dubpixel/DPX_flatbox/dpx-v7/Flatbox-rev7-kicad/Flatbox-rev7.png

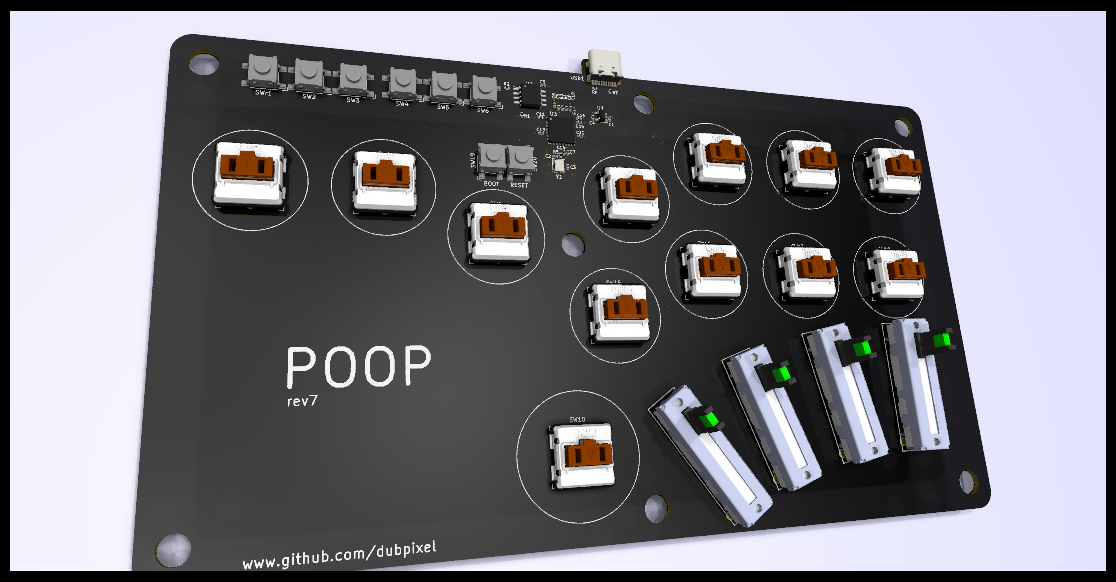
dpx-v7/Flatbox-rev7-kicad/Flatbox-rev7.png
