dubpixel/DPX_flatbox/hardware-rev4_LED-Fightingbox/3d-printed-case/flatbox_rev4_rgb_top.stl

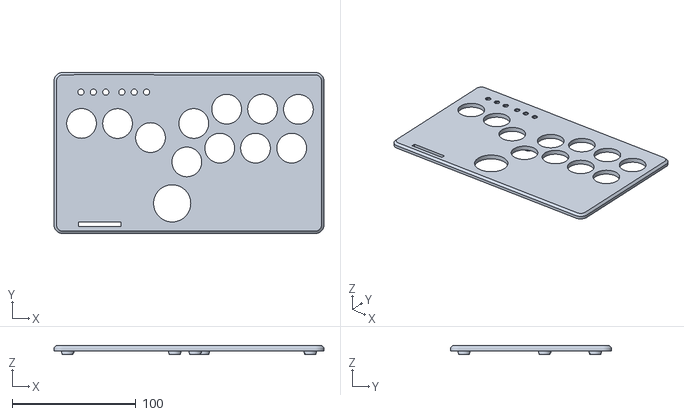
[picture p6: CAD file, 2024-12-09]
hardware-rev4_LED-Fightingbox/3d-printed-case/flatbox_rev4_rgb_top.stl
218.0 x 130.1 x 7.29
