dubpixel/DPX_flatbox/hardware-rev7/3d-printed-case/Flatbox-rev7-Bottom.stl

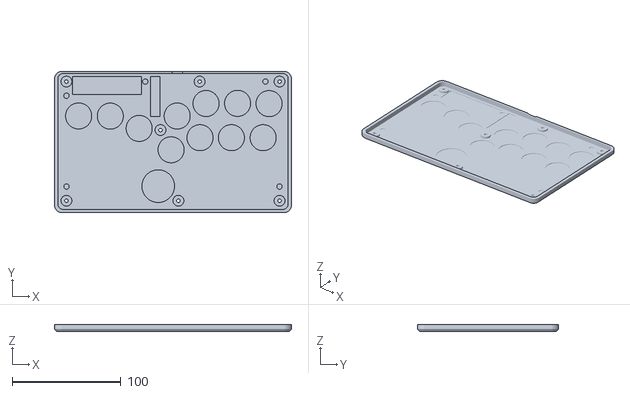
[picture p7: CAD file, 2024-12-09]
hardware-rev7/3d-printed-case/Flatbox-rev7-Bottom.stl
218.0 x 130.0 x 6.20
