dubpixel/DPX_flatbox/hardware-rev4_LED-Fightingbox/3d-printed-case/Flatbox-rev4-Bottom-hotswap.stl

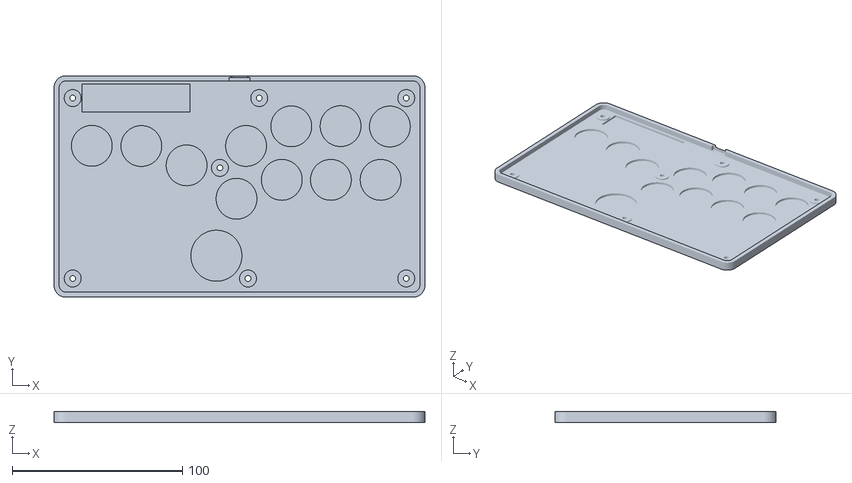
[picture p9: CAD file, 2024-12-09]
hardware-rev4_LED-Fightingbox/3d-printed-case/Flatbox-rev4-Bottom-hotswap.stl
218.0 x 130.1 x 6.20
