dubpixel/DPX_flatbox/hardware-rev7/3d-printed-case/Flatbox-rev7-Top.stl

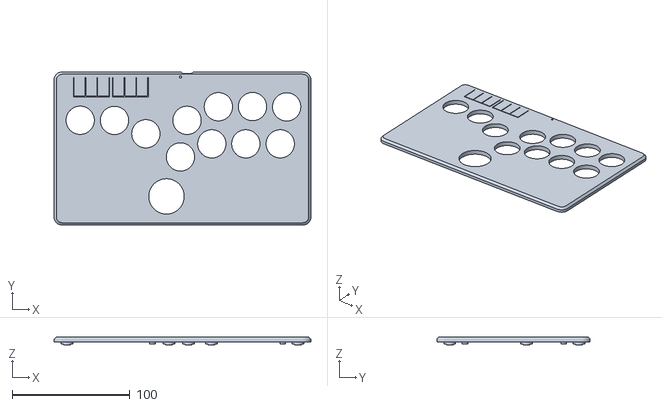
[picture p10: CAD file, 2024-12-09]
hardware-rev7/3d-printed-case/Flatbox-rev7-Top.stl
218.0 x 130.0 x 7.20
