dubpixel/DPX_flatbox/hardware-rev7/extras/Flatbox-rev7-pcb.step

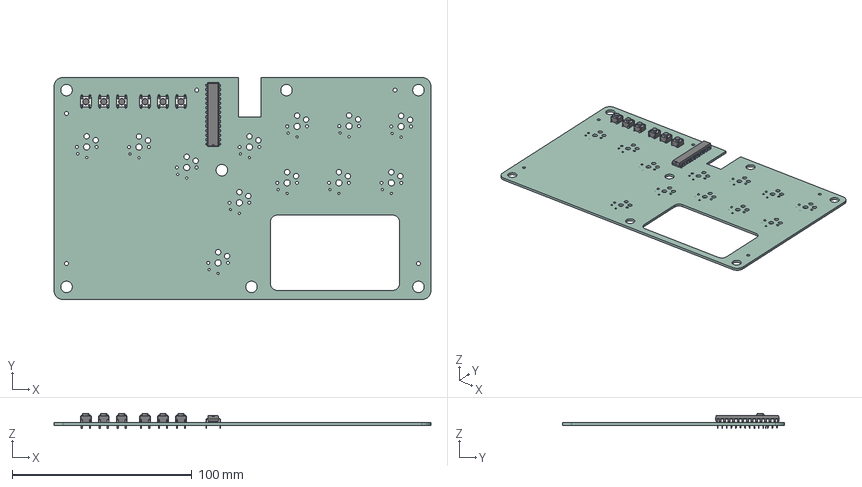
[picture p11: CAD file, 2024-12-09]
hardware-rev7/extras/Flatbox-rev7-pcb.step
210.0 x 123.6 x 8.50 mm
SW_PUSH_6mm_h5mm x 6
DIP-28_W7.62mm
Flatbox-rev7_PCB
