dubpixel/DPX_flatbox/hardware-rev6/3d-printed-case/Flatbox-rev6-Bottom-hotswap.stl

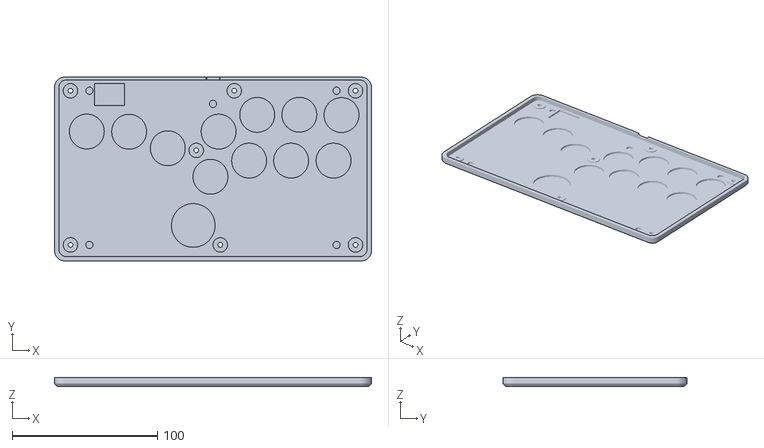
[picture p12: CAD file, 2024-12-09, an earlier design]
hardware-rev6/3d-printed-case/Flatbox-rev6-Bottom-hotswap.stl
218.0 x 126.4 x 6.20
