dubpixel/DPX_flatbox/hardware-rev6/extras/Flatbox-rev6-pcb.step

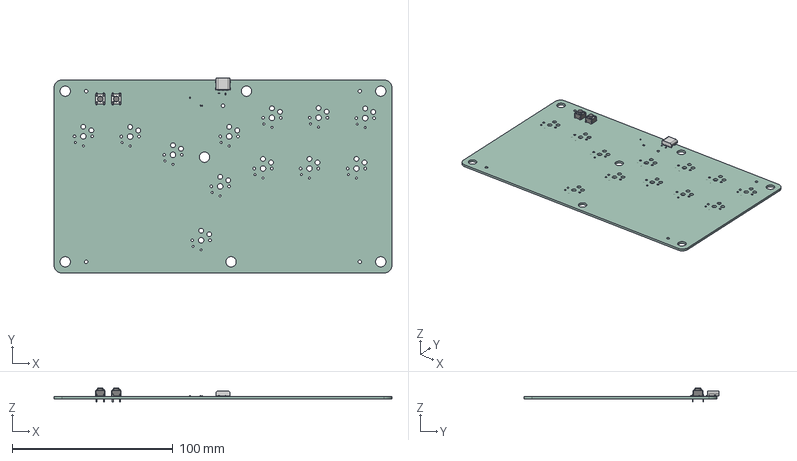
[picture p16: CAD file, 2024-12-09, an earlier design]
hardware-rev6/extras/Flatbox-rev6-pcb.step
210.0 x 121.2 x 8.50 mm
SW_PUSH_6mm_h5mm x 2
R_0402_1005Metric x 3
HRO TYPE-C-31-M-12 v4
C_0402_1005Metric x 2
Flatbox-rev6_PCB
