dubpixel/DPX_flatbox/(list of files, cad)

Other CAD files:
hardware-rev6/extras/Flatbox-rev6-case-hotswap.step
