dubpixel/DPX_flatbox/dpx-v7/Flatbox-rev7-kicad/Flatbox-rev7.kicad_pcb

## KiCad design dpx-v7/Flatbox-rev7-kicad/Flatbox-rev7.kicad_pcb (2024-12-09)

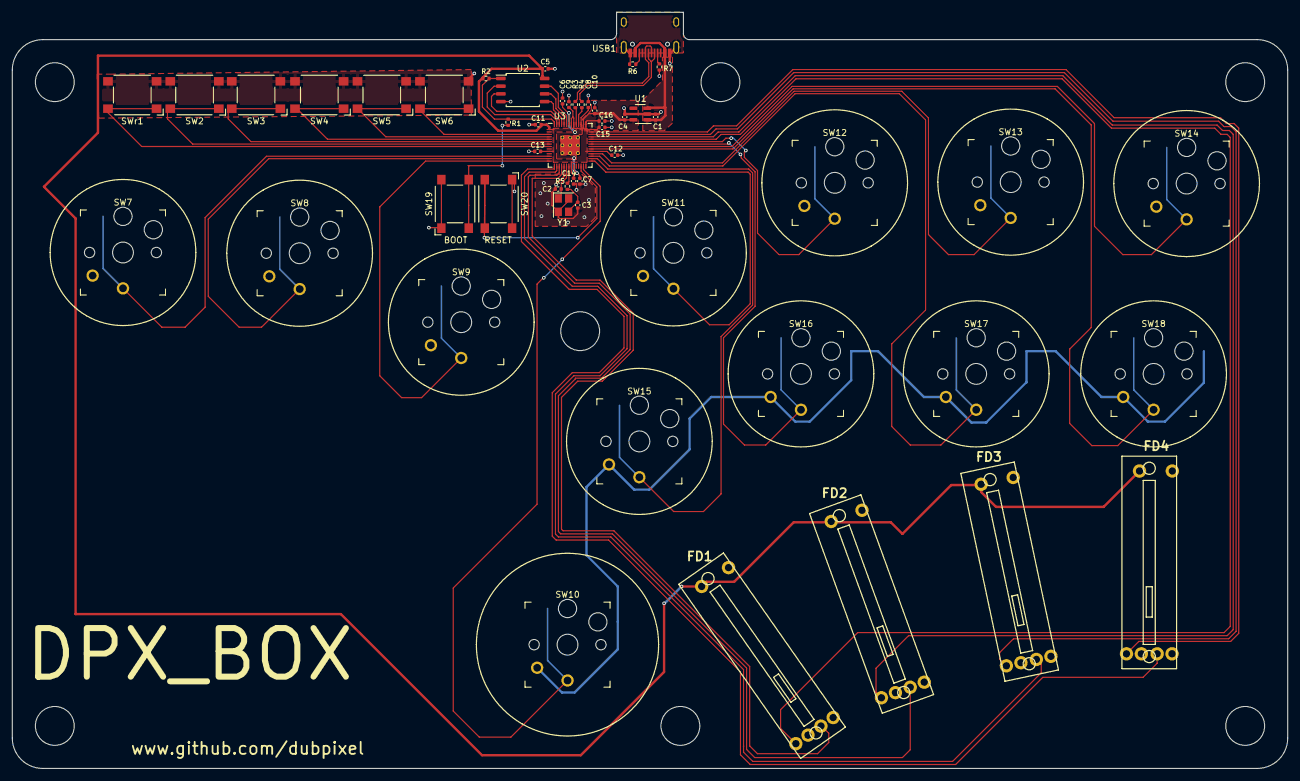
[picture p17: board Flatbox-rev7.kicad_pcb from above]

Board: 2 copper layers, 210.0 x 124.5 mm, 52 parts (0 on the bottom side), 47 nets.

Parts:
C1, C4, C8, C10: 1u; C_0402_1005Metric
C2, C3: 30p; C_0402_1005Metric
C5, C6, C7, C9, C11, C12, C13, C14, C15, C16: 100n; C_0402_1005Metric
F1, F2, F3, F4: BOURNS-PTL2043_20mm-slide-pot
R1, R5: 1k; R_0402_1005Metric
R2: 10k; R_0402_1005Metric
R3, R4: 27; R_0402_1005Metric
R6, R7: 5.1k; R_0402_1005Metric
SW2, SW3, SW4, SW5, SW6, SW19, SW20: SW_Push; SW_SPST_Omron_B3FS-100xP
SW7, SW8, SW9, SW11, SW12, SW13, SW14, SW15, SW16, SW17, SW18: SW_Push; Kailh_socket_PG1350_optional
SW10: SWX10; Kailh_socket_PG1350_optional
SWr1: SW_Push; SW_SPST_Omron_B3FS-100xP
U1: TLV73333PDBV; SOT-23-5
U2: W25Q128JVS; SOIC-8_5.23x5.23mm_P1.27mm
U3: RP2040; RP2040-QFN-56
USB1: HRO-TYPE-C-31-M-12; HRO-TYPE-C-31-M-12-Assembly
Y1: Crystal_GND24; Crystal_SMD_3225-4Pin_3.2x2.5mm

Connections:
+1V1: C6.1, C7.1, C8.1, U3.23 (DVDD), U3.45 (VREG_VOUT), U3.50 (DVDD)
+3V3: C4.1, C5.1, C9.1, C10.1, C11.1, C12.1, C13.1, C14.1, C15.1, C16.1, F1.3, F2.3, F3.3, F4.3, R2.1, U1.5 (OUT), U2.8 (VCC), U3.1 (IOVDD), U3.10 (IOVDD), U3.22 (IOVDD), U3.33 (IOVDD), U3.42 (IOVDD), U3.43 (ADC_AVDD), U3.44 (VREG_IN), U3.48 (USB_VDD), U3.49 (IOVDD)
+5V: C1.1, U1.1 (IN), U1.3 (EN), USB1.2 (VBUS), USB1.11 (VBUS)
ADC0: F1.2, U3.38 (GPIO26_ADC0)
ADC1: F2.2, U3.39 (GPIO27_ADC1)
ADC2: F3.2, U3.40 (GPIO28_ADC2)
ADC3: F4.2, U3.41 (GPIO29_ADC3)
D+: R3.1, USB1.6 (DP1), USB1.8 (DP2)
D-: R4.1, USB1.5 (DN2), USB1.7 (DN1)
GND: C1.2, C2.1, C3.2, C4.2, C5.2, C6.2, C7.2, C8.2, C9.2, C10.2, C11.2, C12.2, C13.2, C14.2, C15.2, C16.2, F1.1, F1.C (CATHODE), F2.C (CATHODE), F3.1, F3.C (CATHODE), F4.1, F4.C (CATHODE), R6.2, R7.2, SW2.2, SW3.2, SW4.2, SW5.2, SW6.2, SW7.2, SW8.2, SW9.2, SW10.2, SW11.2, SW12.2, SW13.2, SW14.2, SW15.2, SW16.2, SW17.2, SW18.2, SW19.1, SW20.1, SWr1.2, U1.2 (GND), U2.4 (GND), U3.19 (TESTEN), U3.57 (GND), USB1.1 (GND), USB1.12 (GND), USB1.13 (SHIELD), Y1.2, Y1.4
LEDF1: F4.L (EN), U3.15 (GPIO12)
LEDF2: F3.L (EN), U3.16 (GPIO13)
LEDF3: F2.L (EN), U3.17 (GPIO14)
LEDF4: F1.L (EN), U3.18 (GPIO15)
unnamed: C3.1, R5.1, Y1.3
unnamed: R1.2, SW19.2
unnamed: SW20.2, U3.26 (RUN)
unnamed: R4.2, U3.46 (USB_DM)
unnamed: R3.2, U3.47 (USB_DP)
unnamed: R7.1, USB1.4 (CC1)
unnamed: R6.1, USB1.10 (CC2)
QSPI_SCLK: U2.6 (CLK), U3.52 (QSPI_SCLK)
QSPI_SD0: U2.5 (DI(IO0)), U3.53 (QSPI_SD0)
QSPI_SD1: U2.2 (DO(IO1)), U3.55 (QSPI_SD1)
QSPI_SD2: U2.3 (IO2), U3.54 (QSPI_SD2)
QSPI_SD3: U2.7 (IO3), U3.51 (QSPI_SD3)
QSPI_SS: R1.1, R2.2, U2.1 (~CS), U3.56 (QSPI_SS)
SWX1: SWr1.1, U3.8 (GPIO6)
SWX2: SW2.1, U3.7 (GPIO5)
SWX3: SW3.1, U3.6 (GPIO4)
SWX4: SW4.1, U3.5 (GPIO3)
SWX5: SW5.1, U3.4 (GPIO2)
SWX6: SW6.1, U3.3 (GPIO1)
SWX7: SW7.1, U3.12 (GPIO9)
SWX8: SW8.1, U3.13 (GPIO10)
SWX9: SW9.1, U3.14 (GPIO11)
SWX10: SW10.1, U3.27 (GPIO16)
SWX11: SW11.1, U3.29 (GPIO18)
SWX12: SW12.1, U3.37 (GPIO25)
SWX13: SW13.1, U3.32 (GPIO21)
SWX14: SW14.1, U3.35 (GPIO23)
SWX15: SW15.1, U3.30 (GPIO19)
SWX16: SW16.1, U3.36 (GPIO24)
SWX17: SW17.1, U3.31 (GPIO20)
SWX18: SW18.1, U3.34 (GPIO22)
XIN: C2.2, U3.20 (XIN), Y1.1
XOUT: R5.2, U3.21 (XOUT)
