dubpixel/DPX_flatbox/(commit log)

2024-12-09 very messy commit - need to reorg
    very very messy messy. - also includes an RGB fork from @mxd1365
    [BOM-Flatbox-rev7.csv, Flatbox-rev4-Bottom-hotswap.stl, Flatbox-rev4-rgb-BOM.csv, Flatbox-rev4-rgb-kicad-SK6812-20.kicad_pcb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]
2024-12-09 manual merge to be in line with main branch
    [Flatbox-rev6-BOM.csv, Flatbox-rev6-Bottom-hotswap.stl, Flatbox-rev6-Bottom.stl, Flatbox-rev6-Top.stl, Flatbox-rev6-case-hotswap.step, Flatbox-rev6-case.step, Flatbox-rev6-pcb.step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]
